justinjchae/poko/pokodoro/Pokodoro/Pokodoro.step

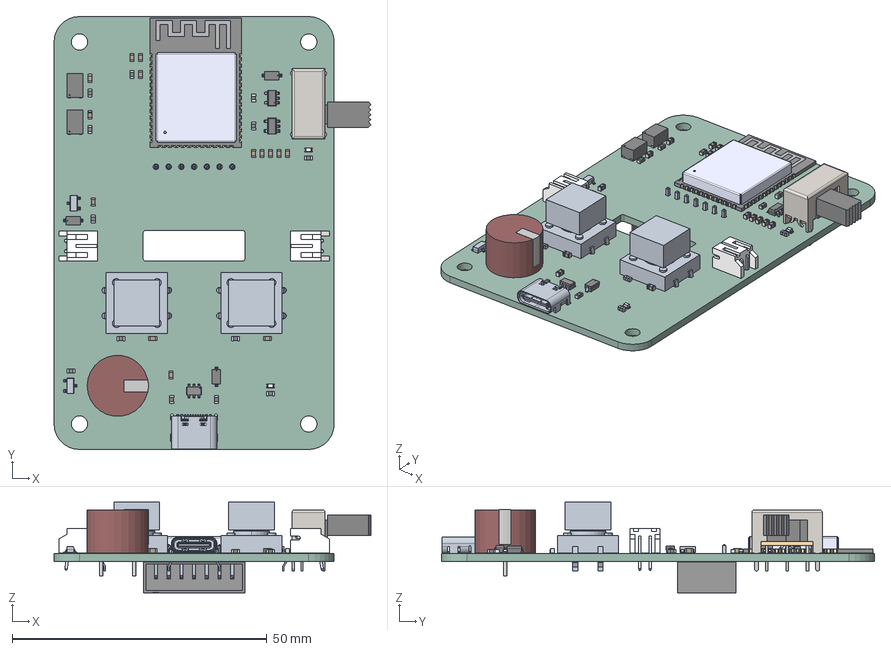
[picture p17: CAD file, 2026-10-15]
pokodoro/Pokodoro/Pokodoro.step
62.2 x 85.0 x 17.8 mm
150060GS75000 x 2
S2B-PH-K-S x 2
B3F_4055 x 2
2N7002 x 2
AP22653W6-7
ESP32-S3-WROOM-1-N8R2
EG1224
ASSEMBLY
Pokodoro_PCB
