justinjchae/poko/pokodoro/Pokodoro/Pokodoro_3DModels/CEM-120342.step

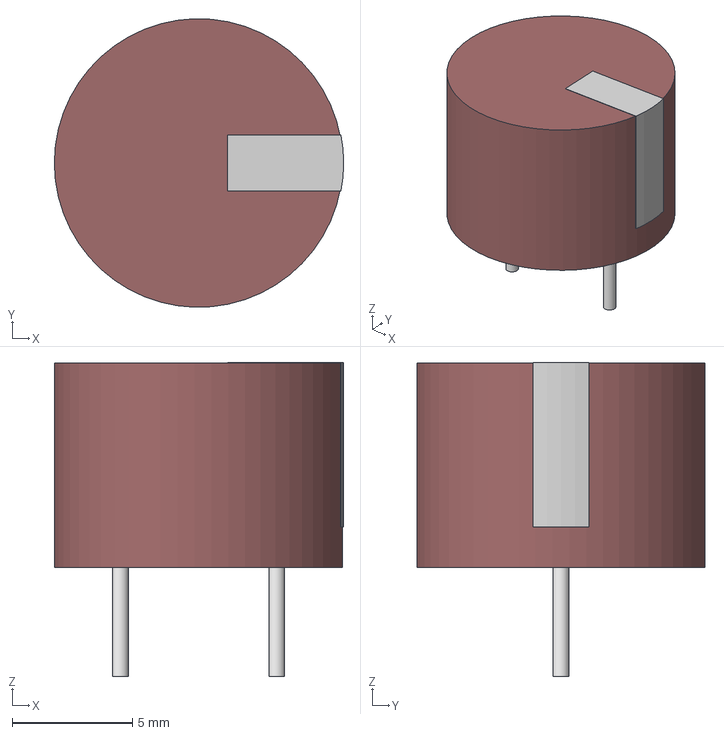
[picture p18: CAD file, 2026-10-15]
pokodoro/Pokodoro/Pokodoro_3DModels/CEM-120342.step
12.0 x 12.0 x 13.0 mm
