justinjchae/poko/pokodoro/Pokodoro/Pokodoro_3DModels/DT1042-04SO-7.step

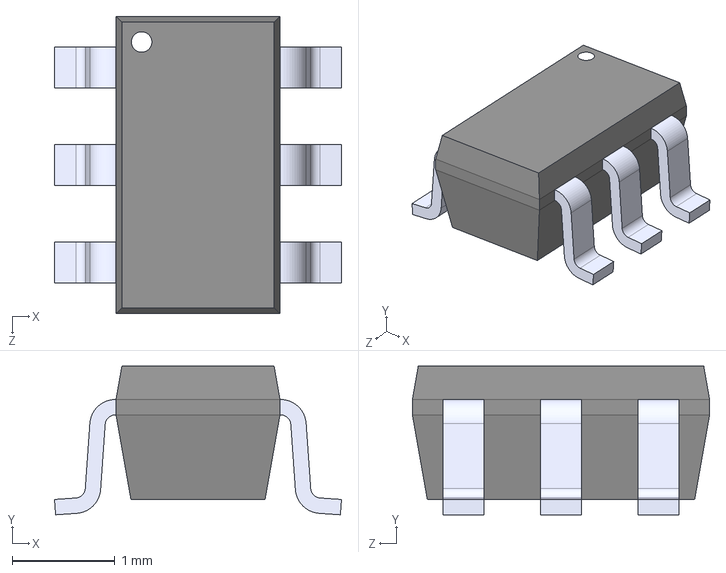
[picture p19: CAD file, 2026-10-15]
pokodoro/Pokodoro/Pokodoro_3DModels/DT1042-04SO-7.step
2.80 x 1.45 x 2.90 mm
