justinjchae/poko/pokodoro/Pokodoro/Pokodoro_3DModels/RC0603N_YAG.step

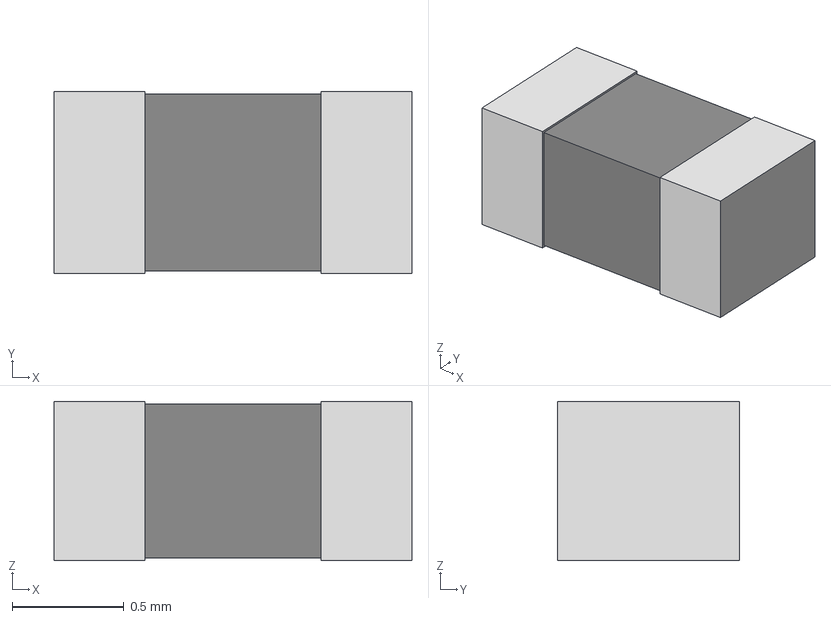
[picture p20: CAD file, 2026-10-15]
pokodoro/Pokodoro/Pokodoro_3DModels/RC0603N_YAG.step
1.60 x 0.812 x 0.711 mm
