justinjchae/poko/pokodoro/Pokodoro/Pokodoro_3DModels/G-188_MUR.step

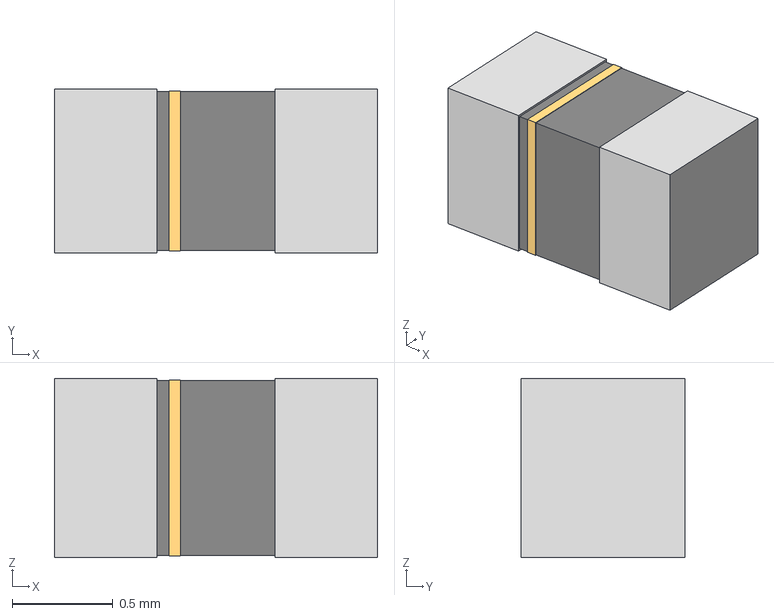
[picture p21: CAD file, 2026-10-15]
pokodoro/Pokodoro/Pokodoro_3DModels/G-188_MUR.step
1.60 x 0.812 x 0.889 mm
