justinjchae/poko/pokodoro/Pokodoro/Pokodoro_3DModels/SOT-23-5_MC_MCH.step

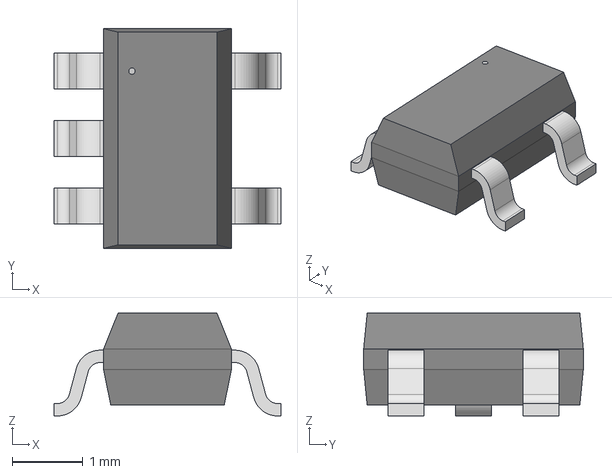
[picture p22: CAD file, 2026-10-15]
pokodoro/Pokodoro/Pokodoro_3DModels/SOT-23-5_MC_MCH.step
3.20 x 3.10 x 1.45 mm
