justinjchae/poko/pokodoro/Pokodoro/Pokodoro_3DModels/1N5819HW-7-F_DIO.step

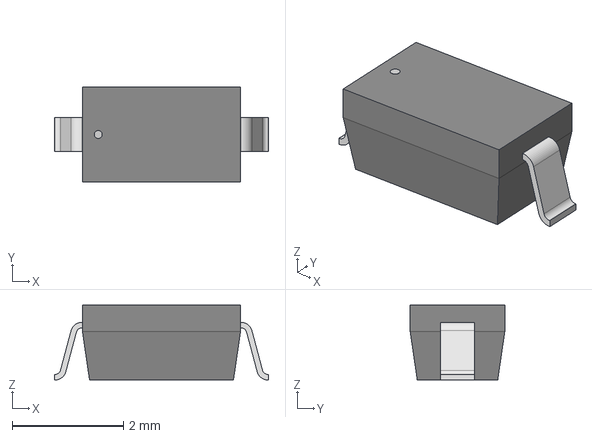
[picture p23: CAD file, 2026-10-15]
pokodoro/Pokodoro/Pokodoro_3DModels/1N5819HW-7-F_DIO.step
3.85 x 1.70 x 1.35 mm
