justinjchae/poko/pokodoro/Pokodoro/Pokodoro_3DModels/SOT-23-5_M5_MCH.step

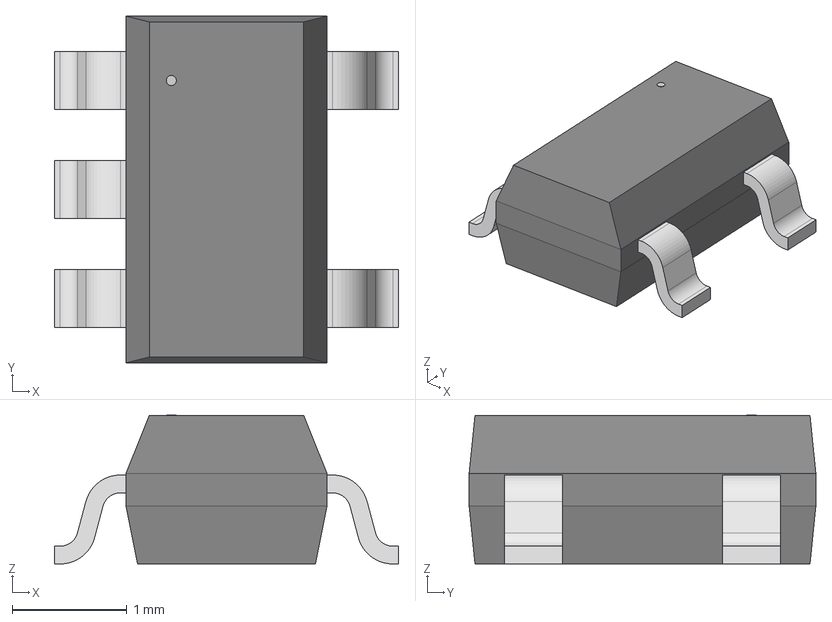
[picture p24: CAD file, 2026-10-15]
pokodoro/Pokodoro/Pokodoro_3DModels/SOT-23-5_M5_MCH.step
3.00 x 3.02 x 1.30 mm
