justinjchae/poko/pokodoro/Pokodoro/Pokodoro_3DModels/PTS810.step

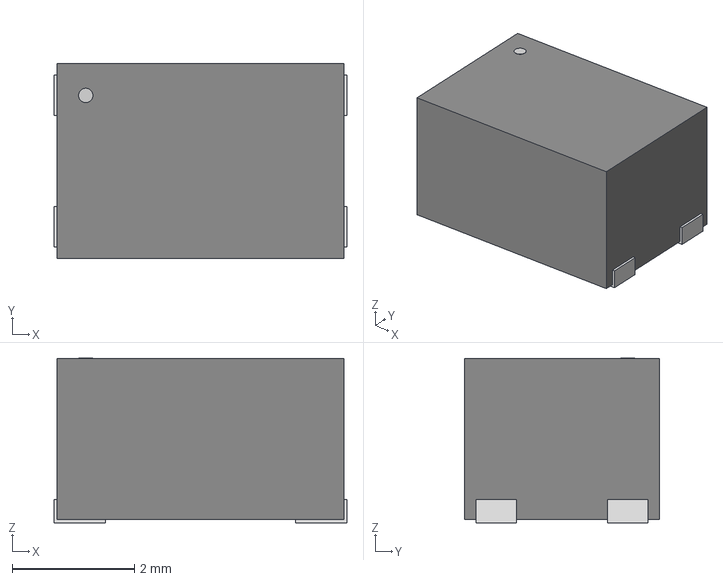
[picture p25: CAD file, 2026-10-15]
pokodoro/Pokodoro/Pokodoro_3DModels/PTS810.step
4.80 x 3.20 x 2.69 mm
