justinjchae/poko/pokodoro/Pokodoro/Pokodoro_3DModels/CAP_CL10_SAM.step

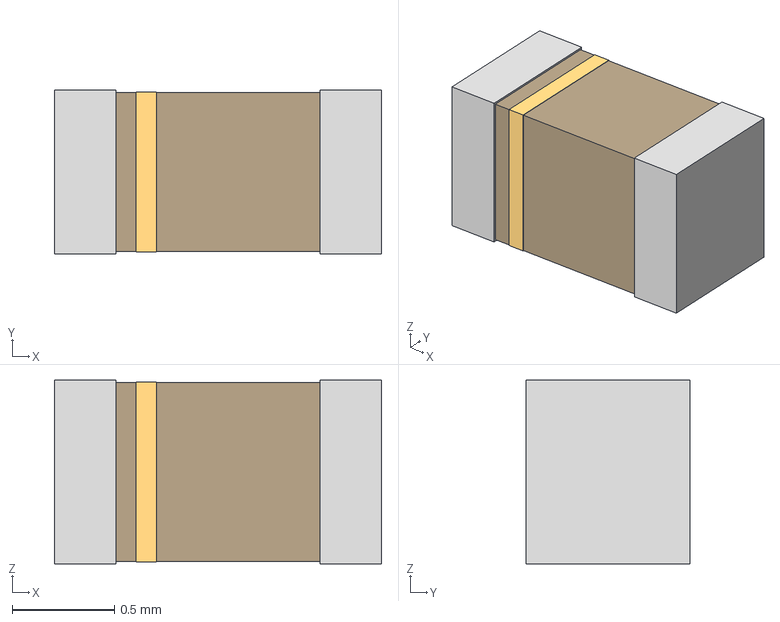
[picture p26: CAD file, 2026-10-15]
pokodoro/Pokodoro/Pokodoro_3DModels/CAP_CL10_SAM.step
1.60 x 0.8 x 0.9 mm
