justinjchae/poko/pokodoro/Pokodoro/Pokodoro_3DModels/S7B-XH-A-1.step

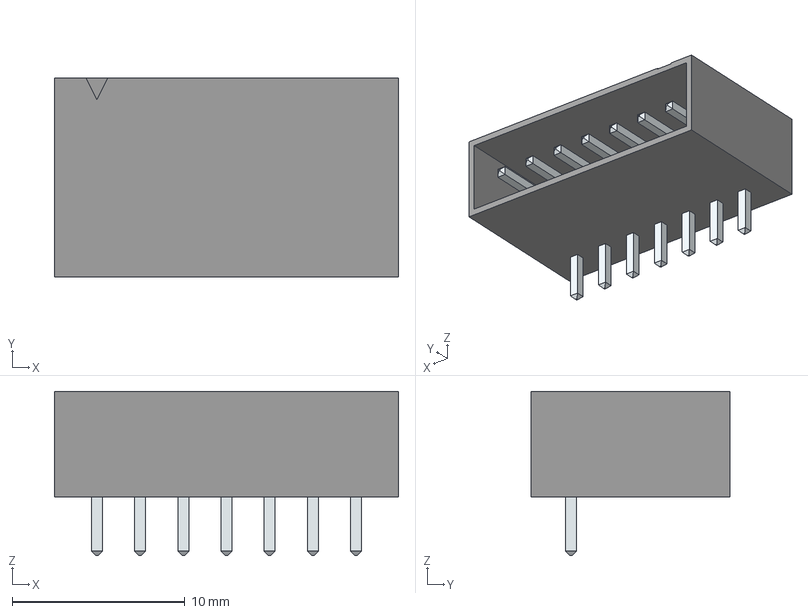
[picture p27: CAD file, 2026-10-15]
pokodoro/Pokodoro/Pokodoro_3DModels/S7B-XH-A-1.step
19.9 x 11.5 x 9.50 mm
LeadsArray
