justinjchae/poko/pokodoro/Pokodoro/Pokodoro.kicad_pcb

## KiCad design pokodoro/Pokodoro/Pokodoro.kicad_pcb (2026-10-15)

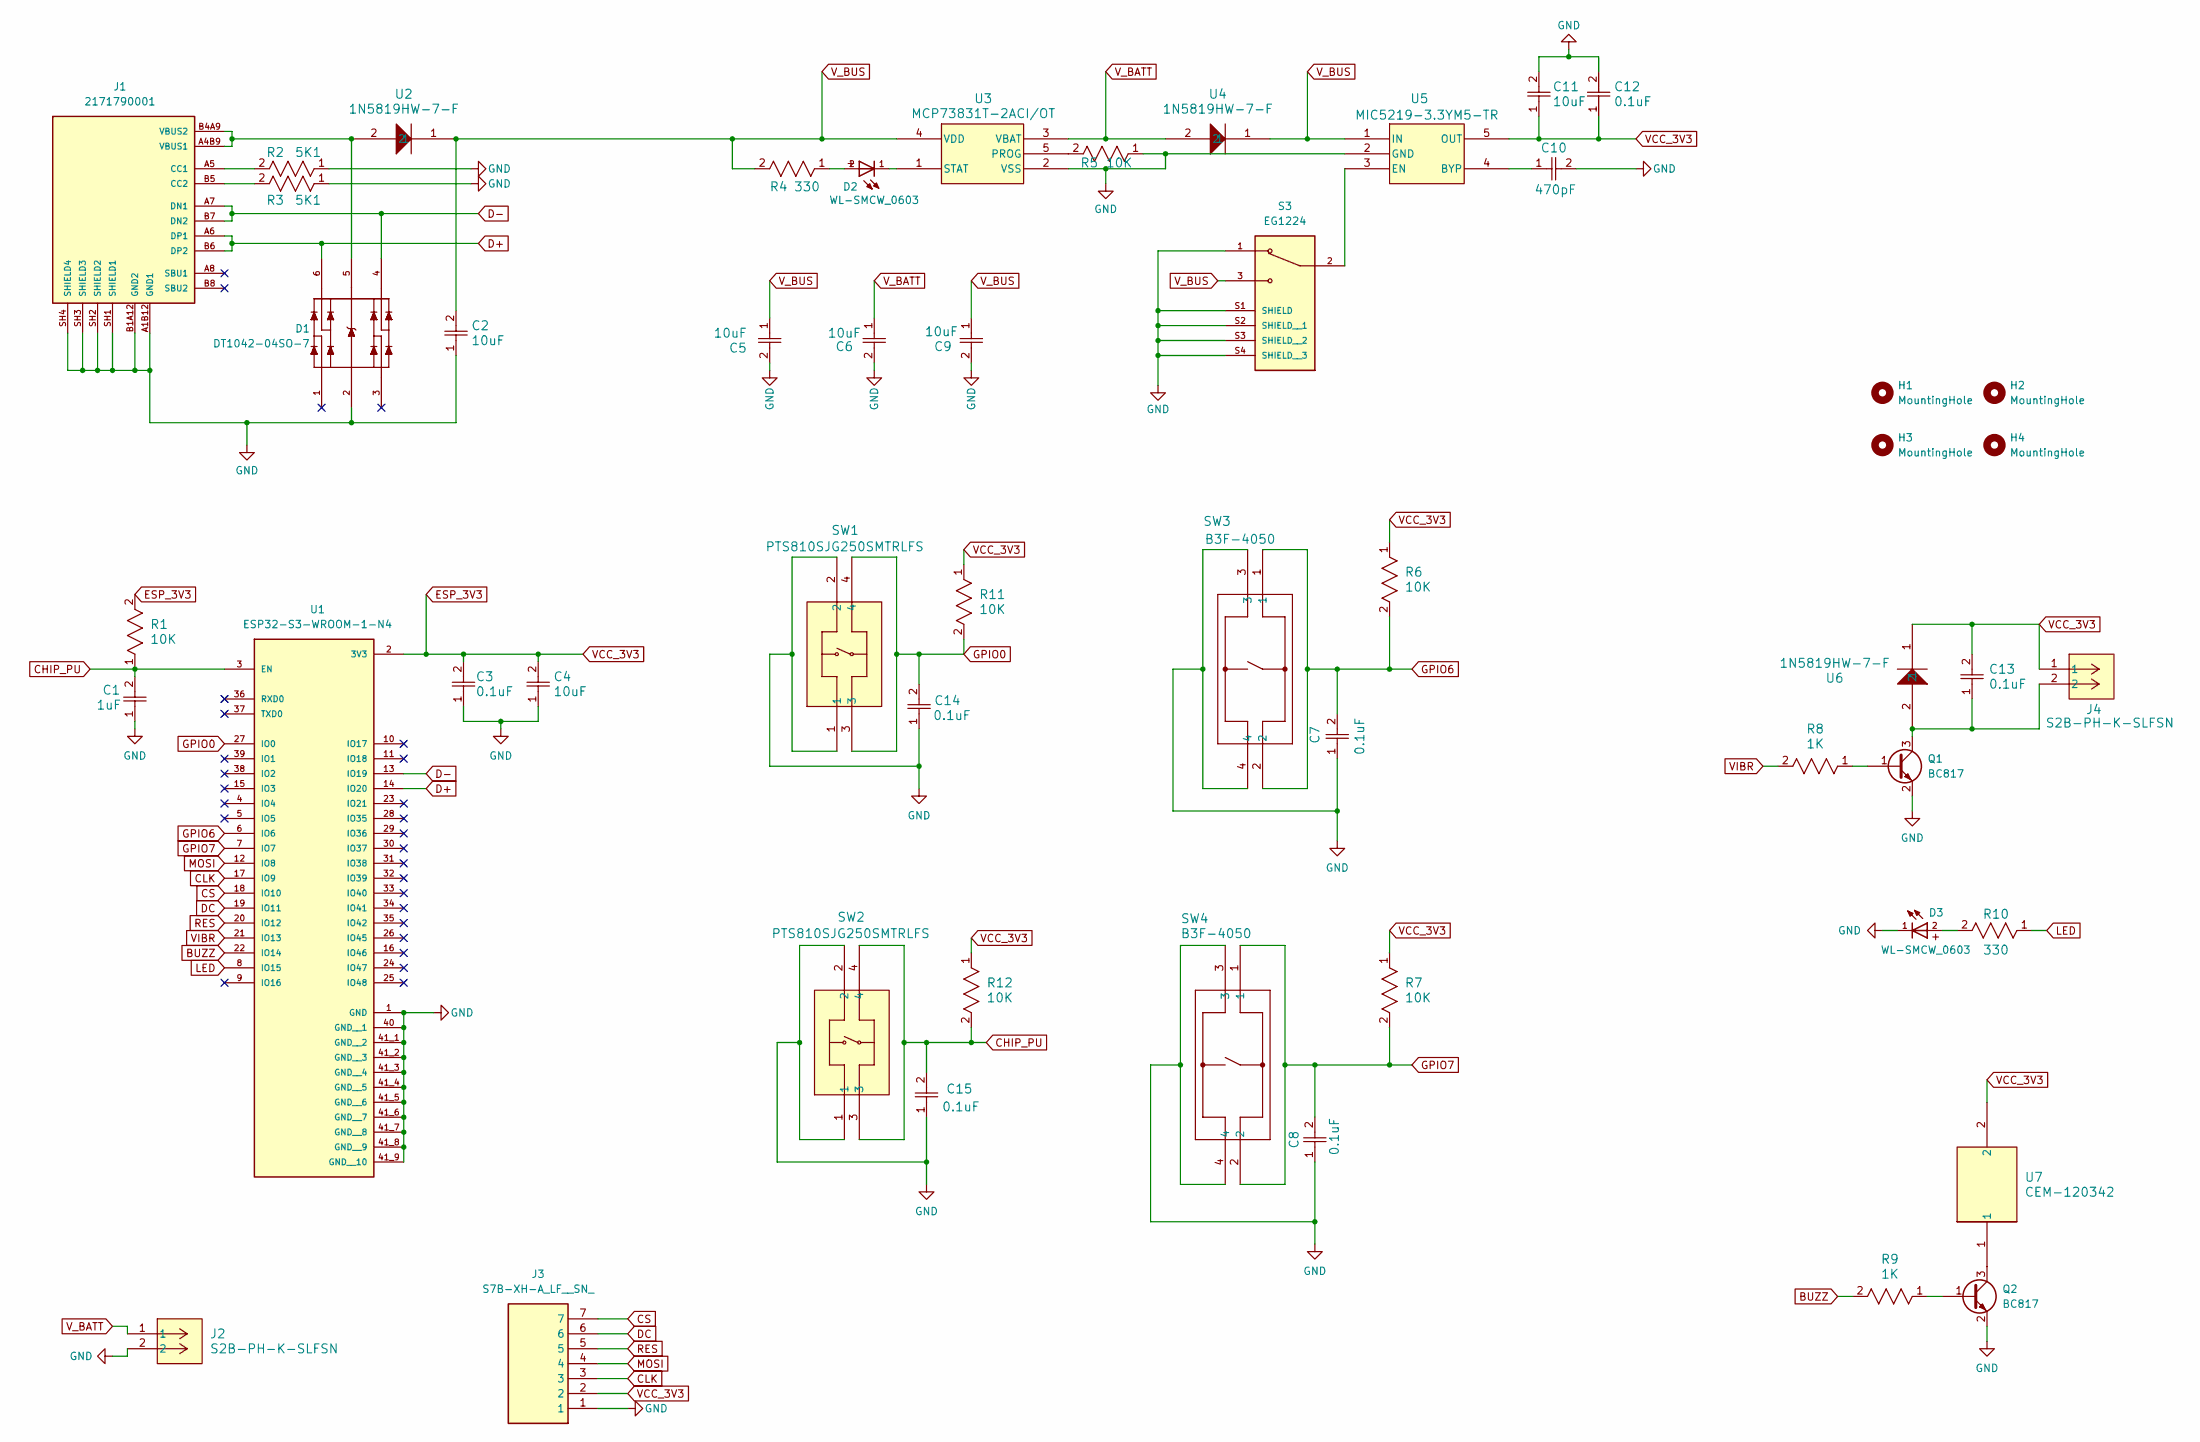
[picture p28: schematic Pokodoro.kicad_sch]

Parts:
C1: 1uF; CAP_CL10_SAM
C2, C4, C5, C6, C9, C11: 10uF; CAP_CL10_SAM
C3, C7, C8, C12, C13, C14, C15: 0.1uF; CAP_CL10_SAM
C10: 470pF; G-188_MUR
D1: DT1042-04SO-7; DT1042-04SO; PARTREV 2-2; DigiKey_Part_Number DT1042-04SO-7DITR-ND
D2, D3: WL-SMCW_0603
H1, H2, H3, H4: MountingHole; MountingHole_3.2mm_M3
J1: 2171790001; USBC_MOLEX_2171790001; PARTREV A1
J2, J4: S2B-PH-K-SLFSN; S2B-PH-K-S
J3: S7B-XH-A_LF__SN_; S7B-XH-A-1; Mouser Part Number 306-S7B-XH-ALFSN
Q1, Q2: BC817; BC817-40
R1, R5, R6, R7, R11, R12: 10K; RC0603N_YAG
R2, R3: 5K1; RC0603N_YAG
R4, R10: 330; RC0603N_YAG
R8, R9: 1K; RC0603N_YAG
S3: EG1224; PARTREV A
SW1, SW2: PTS810SJG250SMTRLFS; PTS810
SW3, SW4: B3F-4050
U1: ESP32-S3-WROOM-1-N4; PARTREV v1.0
U2, U4, U6: 1N5819HW-7-F; 1N5819HW-7-F_DIO
U3: MCP73831T-2ACI/OT; SOT-23-5_MC_MCH
U5: MIC5219-3.3YM5-TR; SOT-23-5_M5_MCH
U7: CEM-120342

Connections:
BUZZ: R9.2, U1.22 (IO14)
CHIP_PU: C1.2, C15.2, R1.1, R12.2, SW2.3, SW2.4, U1.3 (EN)
CLK: J3.3, U1.17 (IO9)
CS: J3.7, U1.18 (IO10)
D+: D1.6, J1.A6 (DP1), J1.B6 (DP2), U1.14 (IO20)
D-: D1.4, J1.A7 (DN1), J1.B7 (DN2), U1.13 (IO19)
DC: J3.6, U1.19 (IO11)
ESP_3V3: C3.2, C4.2, C11.1, C12.1, C13.2, J3.2, J4.1, R1.2, R6.1, R7.1, R11.1, R12.1, U1.2 (3V3), U5.5 (OUT), U6.1, U7.2
GND: C1.1, C2.1, C3.1, C4.1, C5.2, C6.2, C7.1, C8.1, C9.2, C10.2, C11.2, C12.2, C14.1, C15.1, D1.2, D3.1, J1.A1B12 (GND1), J1.B1A12 (GND2), J1.SH1 (SHIELD1), J1.SH2 (SHIELD2), J1.SH3 (SHIELD3), J1.SH4 (SHIELD4), J2.2, J3.1, Q1.2 (E), Q2.2 (E), R2.1, R3.1, R5.1, S3.1, S3.S1 (SHIELD), S3.S2 (SHIELD__1), S3.S3 (SHIELD__2), S3.S4 (SHIELD__3), SW1.1, SW1.2, SW2.1, SW2.2, SW3.3, SW3.4, SW4.3, SW4.4, U1.1 (GND), U1.40 (GND__1), U1.41_1 (GND__2), U1.41_2 (GND__3), U1.41_3 (GND__4), U1.41_4 (GND__5), U1.41_5 (GND__6), U1.41_6 (GND__7), U1.41_7 (GND__8), U1.41_8 (GND__9), U1.41_9 (GND__10), U1.41_10, U1.41_11, U1.41_12, U1.41_13, U1.41_14, U1.41_15, U1.41_16, U1.41_17, U1.41_18, U1.41_19, U1.41_20, U1.41_21, U3.2 (VSS), U5.2 (GND)
GPIO0: C14.2, R11.2, SW1.3, SW1.4, U1.27 (IO0)
GPIO6: C7.2, R6.2, SW3.1, SW3.2, U1.6 (IO6)
GPIO7: C8.2, R7.2, SW4.1, SW4.2, U1.7 (IO7)
LED: R10.1, U1.8 (IO15)
MOSI: J3.4, U1.12 (IO8)
unnamed: D2.2, R4.1
unnamed: D3.2, R10.2
unnamed: J1.A5 (CC1), R2.2
unnamed: J1.B5 (CC2), R3.2
unnamed: D1.5, J1.A4B9 (VBUS1), J1.B4A9 (VBUS2), U2.2
unnamed: Q1.1 (B), R8.1
unnamed: C13.1, J4.2, Q1.3 (C), U6.2
unnamed: Q2.1 (B), R9.1
unnamed: Q2.3 (C), U7.1
unnamed: R5.2, U3.5 (PROG)
unnamed: D2.1, U3.1 (STAT)
unnamed: C10.1, U5.4 (BYP)
unnamed: S3.2, U5.3 (EN)
RES: J3.5, U1.20 (IO12)
VIBR: R8.2, U1.21 (IO13)
V_BATT: C6.1, J2.1, U3.3 (VBAT), U4.2
V_BUS: C2.2, C5.1, C9.1, R4.2, S3.3, U2.1, U3.4 (VDD), U4.1, U5.1 (IN)

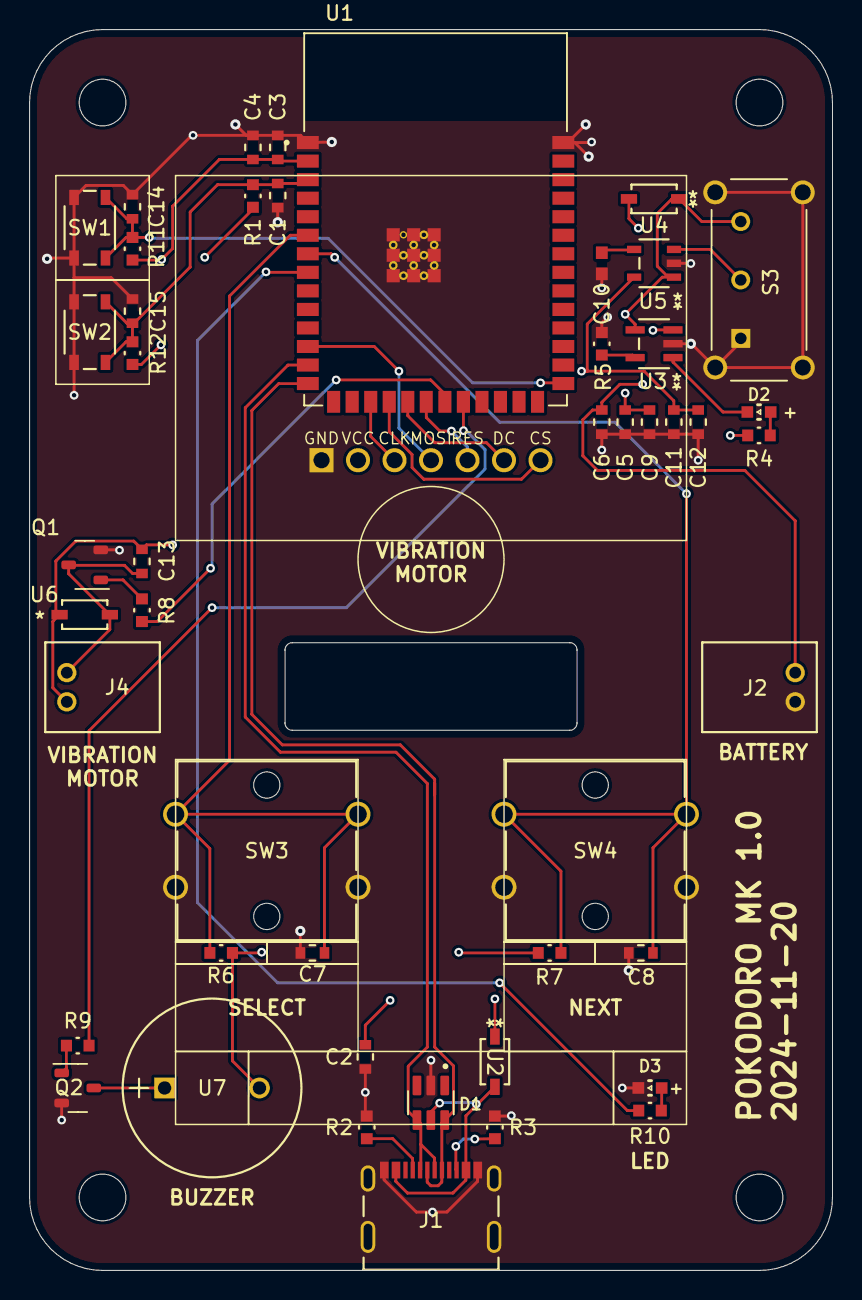
[picture p29: board Pokodoro.kicad_pcb from above]

Board: 4 copper layers, 55.0 x 85.0 mm, 52 parts (1 on the bottom side), 31 nets.
