justinjchae/poko/(commit log)

2026-10-15 Poko: phone-free MagSafe companion (hardware showcase)
    README, photos, requirements and hardware decisions, Fusion 360 CAD
    scripts, ring test-rig tools, hardware docs, and the Pokodoro v0 KiCad
    project.
2026-10-15 README: front-view hero photo of the V1B prototype; opened view moves to the hardware photo row
2026-10-15 README: demo GIF from the V1B prototype (Pomodoro, workouts, memos, Now Playing) replaces the breadboard clip
